shiirchandra/esp_racer_car/mechanical/main-enclosure.step

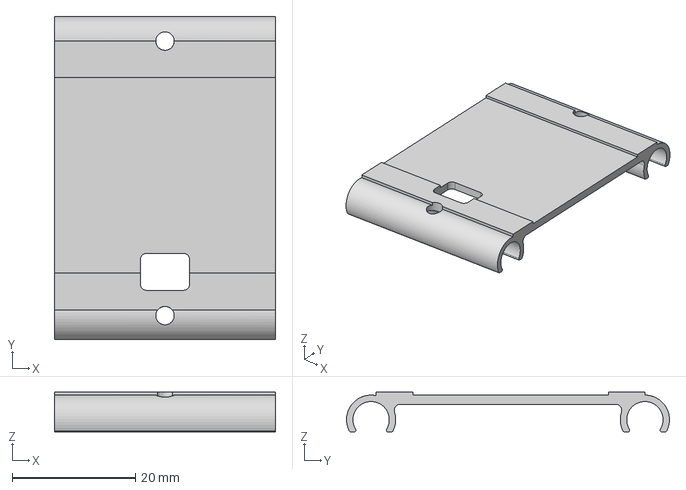
[picture p1: CAD file, 2025-01-25]
mechanical/main-enclosure.step
36.0 x 52.5 x 6.50 mm
