shiirchandra/esp_racer_car/mechanical/wheel.step

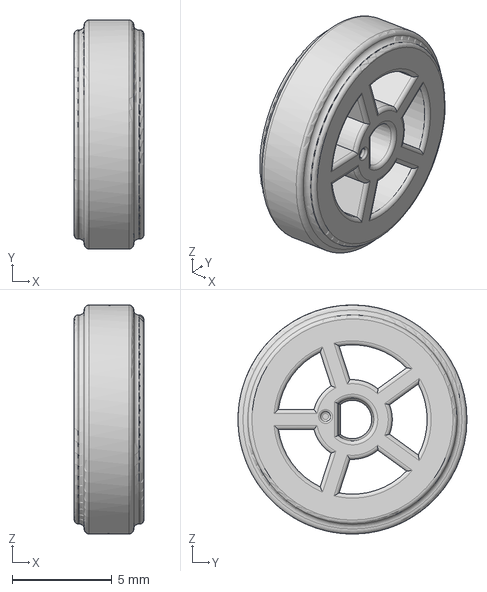
[picture p2: CAD file, 2025-01-25]
mechanical/wheel.step
3.50 x 11.5 x 11.5 mm
