shiirchandra/esp_racer_car/mechanical/top-enclosure.step

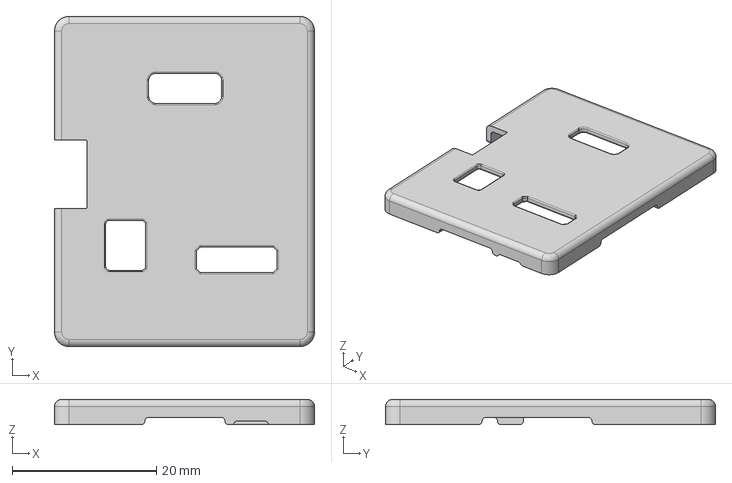
[picture p3: CAD file, 2025-01-25]
mechanical/top-enclosure.step
36.0 x 45.7 x 3.50 mm
