shiirchandra/esp_racer_car/hardware/thumbtroller/controller.kicad_pcb

## KiCad design hardware/thumbtroller/controller.kicad_pcb (2025-01-25)

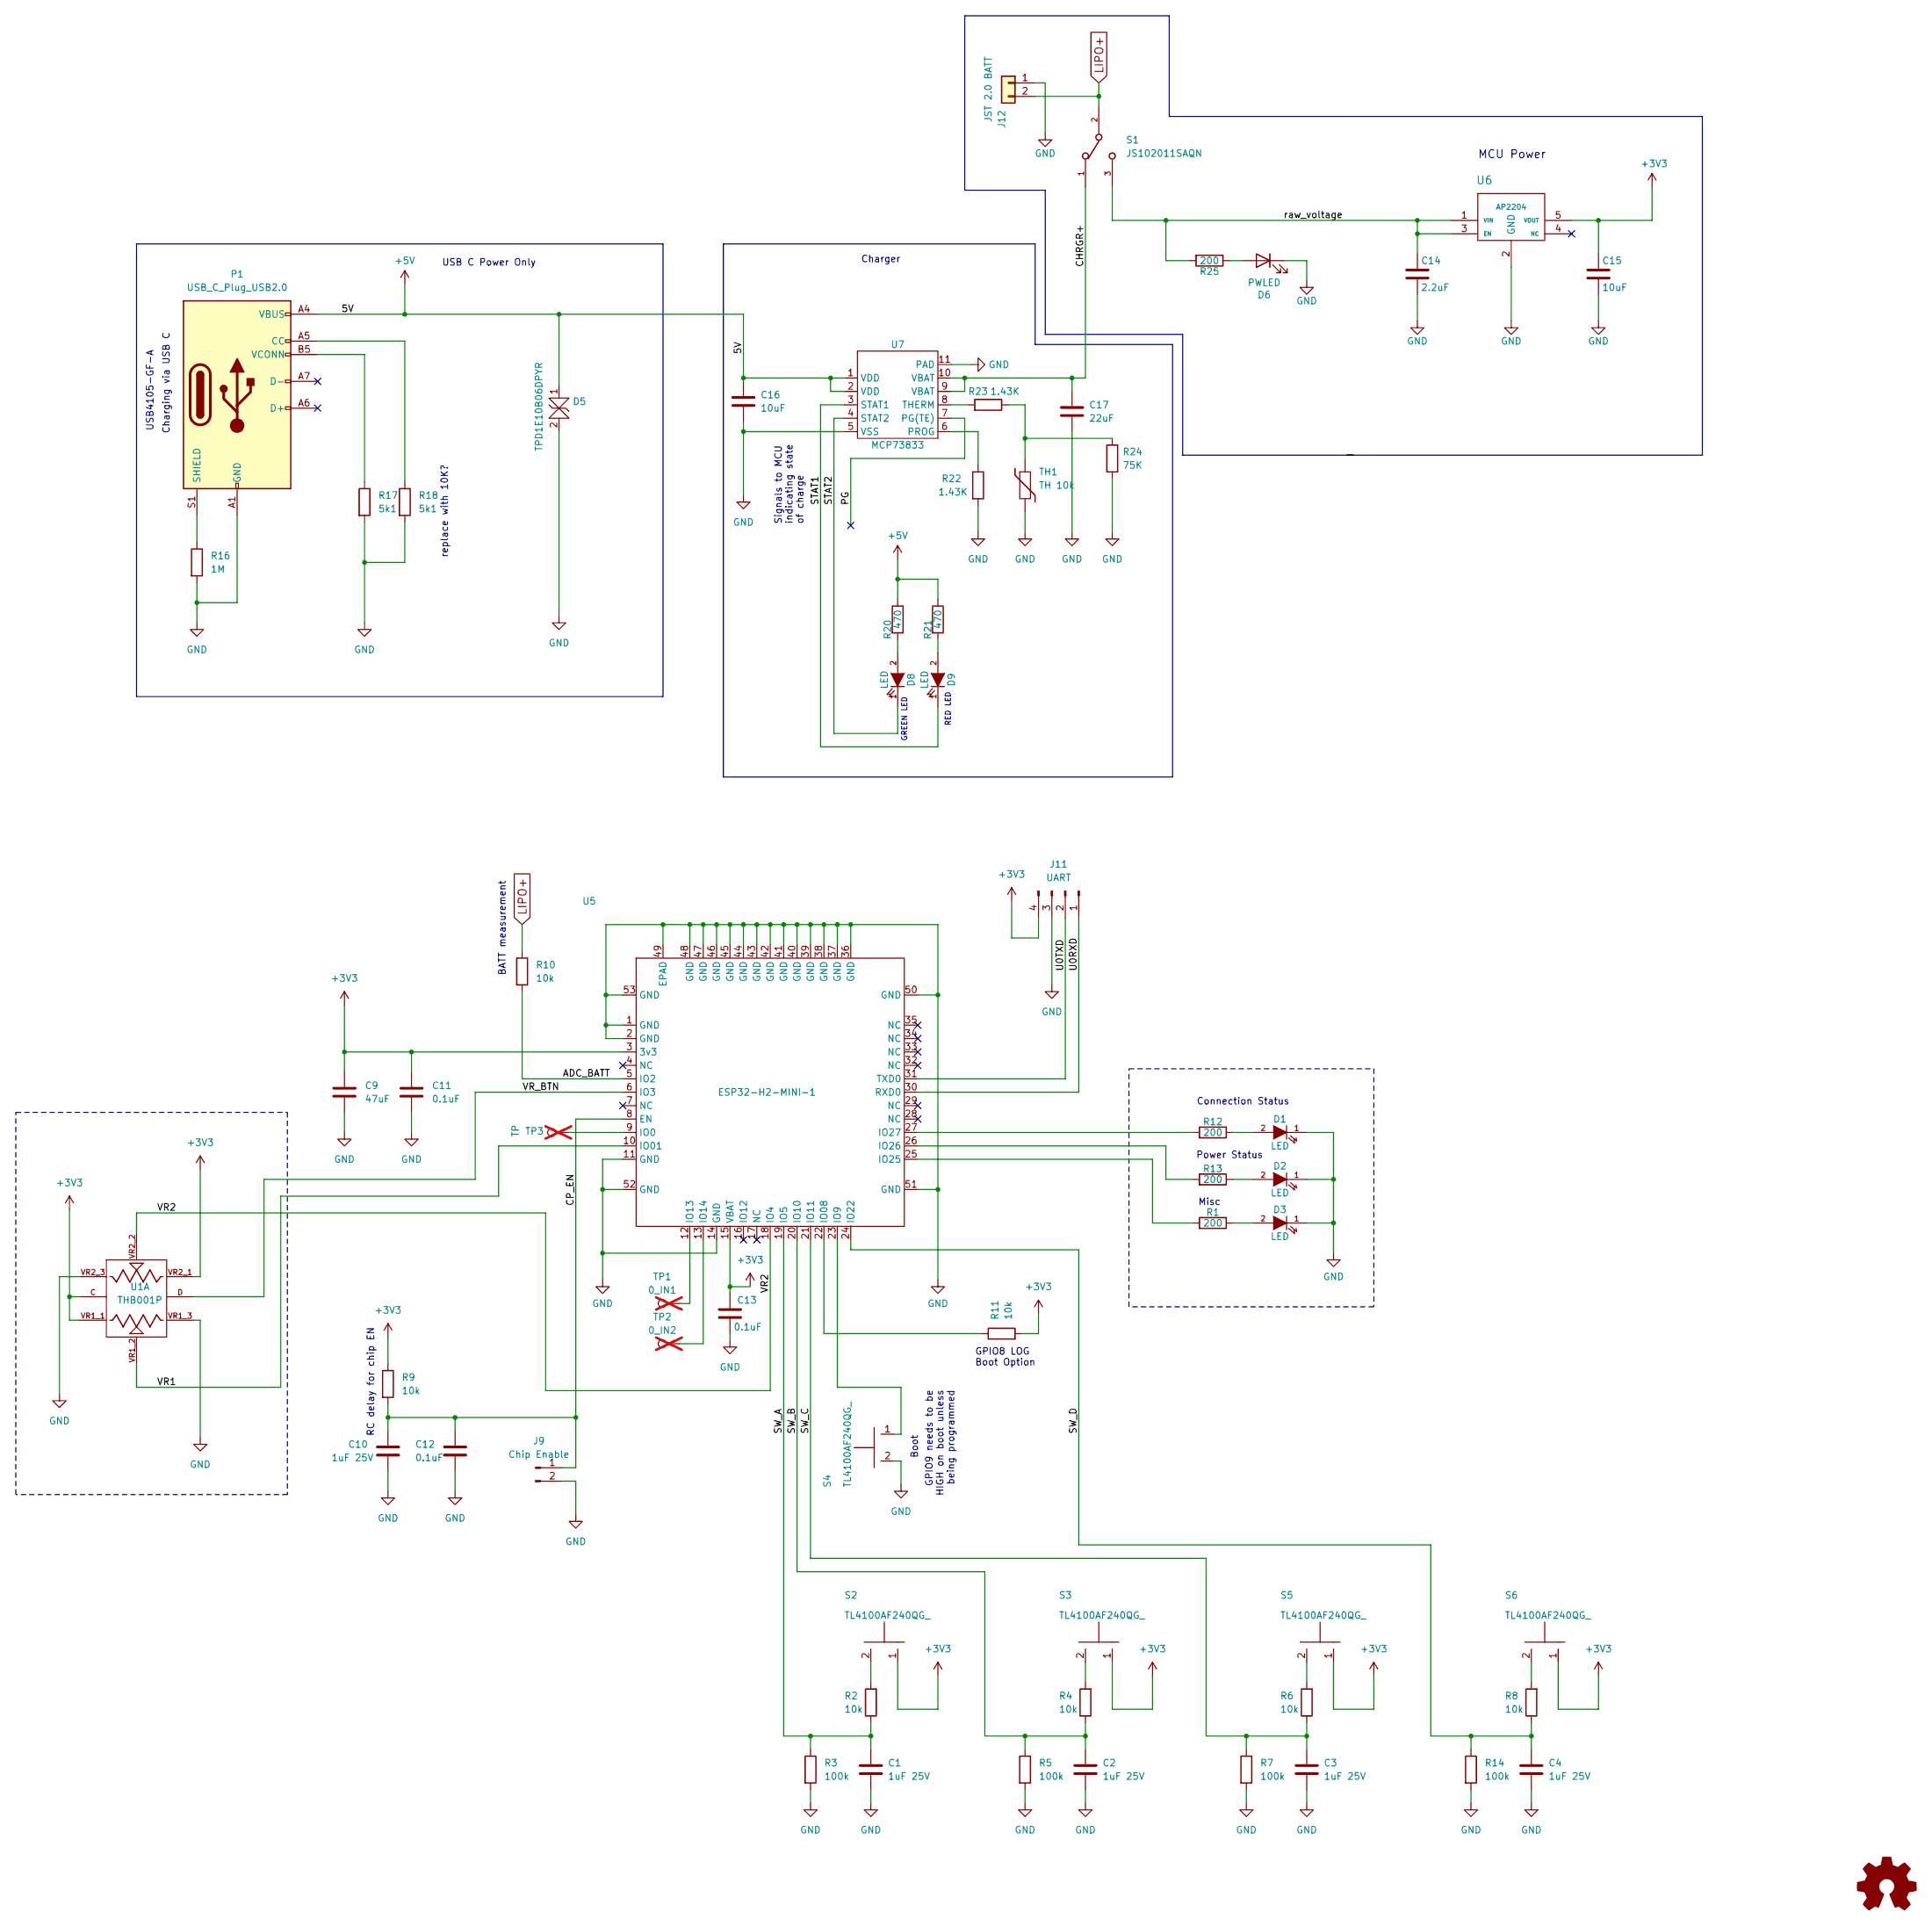
[picture p4: schematic controller.kicad_sch, Thumbtroller]

Parts:
C1, C2, C3, C4, C10: 1uF 25V; C_0603_1608Metric
C9: 47uF; C_0603_1608Metric
C11, C12, C13: 0.1uF; C_0603_1608Metric
C14: 2.2uF; C_0603_1608Metric
C15, C16: 10uF; C_0603_1608Metric
C17: 22uF; C_0603_1608Metric
D1, D2, D3, D8, D9: LED; C_0603_1608Metric
D5: TPD1E10B06DPYR; D_SOD-523
D6: PWLED; D_0603_1608Metric
J9: Chip Enable; PinHeader_1x02_P2.54mm_Vertical
J11: UART; PinHeader_1x04_P2.54mm_Vertical
J12: JST 2.0 BATT; JST_PH_B2B-PH-K_1x02_P2.00mm_Vertical
P1: USB_C_Plug_USB2.0; GCT_USB4105-GF-A
R1, R12, R13, R25: 200; R_0603_1608Metric
R2, R4, R6, R8, R9, R10, R11: 10k; R_0603_1608Metric
R3, R5, R7, R14: 100k; R_0603_1608Metric
R16: 1M; R_0603_1608Metric
R17, R18: 5k1; R_0603_1608Metric
R20, R21: 470; R_0603_1608Metric
R22, R23: 1.43K; R_0603_1608Metric
R24: 75K; R_0603_1608Metric
S1: JS102011SAQN; SW_JS102011SAQN
S2, S3, S4, S5, S6: TL4100AF240QG_; SW_PTS810_SJM_250_SMTR_LFS
TH1: TH 10k; R_0603_1608Metric
TP1: 0_IN1; TestPoint_Pad_1.0x1.0mm; not fitted
TP2: 0_IN2; TestPoint_Pad_1.0x1.0mm; not fitted
TP3: TP; TestPoint_Pad_D1.0mm; not fitted
U1: THB001P; CNK_THB001P; PARTREV 27 Jan 22
U5: ESP32-H2-MINI-1; MODULE_ESP32-H2-MINI-1-H2
U6: AP2204
U7: MCP73833; SON50P300X300X100-11N

Connections:
+3V3: C9.1, C11.1, C13.1, C15.1, J11.4, R9.1, R11.2, S2.1, S3.1, S5.1, S6.1, U1.C, U1.VR1_1, U1.VR2_1, U5.3 (3v3), U5.15 (VBAT), U6.5 (VOUT)
+5V: C16.1, D5.1, P1.A4 (VBUS), P1.A9 (VBUS), P1.B4 (VBUS), P1.B9 (VBUS), R20.1, R21.1, U7.1 (VDD), U7.2 (VDD)
/ADC_BATT: R10.2, U5.5 (IO2)
/CHRGR+: C17.1, S1.1, U7.9 (VBAT), U7.10 (VBAT)
/CP_EN: C10.1, C12.1, J9.1, R9.2, U5.8 (EN)
/PG: U7.7 (PG(TE))
/STAT1: D9.1 (K), U7.3 (STAT1)
/STAT2: D8.1 (K), U7.4 (STAT2)
/SW_A: C1.1, R2.1, R3.1, U5.19 (IO5)
/SW_B: C2.1, R4.1, R5.1, U5.20 (IO10)
/SW_C: C3.1, R6.1, R7.1, U5.21 (IO11)
/SW_D: C4.1, R8.1, R14.1, U5.24 (IO22)
/U0RXD: J11.1, U5.30 (RXD0)
/U0TXD: J11.2, U5.31 (TXD0)
/VR1: U1.VR1_2, U5.10 (IO01)
/VR2: U1.VR2_2, U5.18 (IO4)
/VR_BTN: U1.D, U5.6 (IO3)
/raw_voltage: C14.1, R25.2, S1.3, U6.1 (VIN), U6.3 (EN)
GND: C1.2, C2.2, C3.2, C4.2, C9.2, C10.2, C11.2, C12.2, C13.2, C14.2, C15.2, C16.2, C17.2, D1.1 (K), D2.1 (K), D3.1 (K), D5.2, D6.1 (K), J9.2, J11.3, J12.1, P1.A1 (GND), P1.A12 (GND), P1.B1 (GND), P1.B12 (GND), R3.2, R5.2, R7.2, R14.2, R16.2, R17.2, R18.2, R22.2, R24.1, S4.2, TH1.2, U1.VR1_3, U1.VR2_3, U5.1 (GND), U5.2 (GND), U5.11 (GND), U5.14 (GND), U5.36 (GND), U5.37 (GND), U5.38 (GND), U5.39 (GND), U5.40 (GND), U5.41 (GND), U5.42 (GND), U5.43 (GND), U5.44 (GND), U5.45 (GND), U5.46 (GND), U5.47 (GND), U5.48 (GND), U5.49 (EPAD), U5.50 (GND), U5.51 (GND), U5.52 (GND), U5.53 (GND), U6.2 (GND), U7.5 (VSS), U7.11 (PAD)
LIPO+: J12.2, R10.1, S1.2
unnamed: D1.2 (A), R12.1
unnamed: D2.2 (A), R13.1
unnamed: D3.2 (A), R1.1
unnamed: D6.2 (A), R25.1
unnamed: D8.2 (A), R20.2
unnamed: D9.2 (A), R21.2
unnamed: P1.A5 (CC), R18.1
unnamed: P1.S1 (SHIELD), R16.1
unnamed: P1.B5 (VCONN), R17.1
unnamed: R2.2, S2.2
unnamed: R4.2, S3.2
unnamed: R6.2, S5.2
unnamed: R8.2, S6.2
unnamed: R23.1, R24.2, TH1.1
unnamed: TP3.1, U5.9 (IO0)
unnamed: R11.1, U5.22 (IO08)
unnamed: S4.1, U5.23 (IO9)
unnamed: TP1.1, U5.12 (IO13)
unnamed: TP2.1, U5.13 (IO14)
unnamed: R1.2, U5.25 (IO25)
unnamed: R13.2, U5.26 (IO26)
unnamed: R12.2, U5.27 (IO27)
unnamed: R22.1, U7.6 (PROG)
unnamed: R23.2, U7.8 (THERM)

Notes on the sheet:
RED LED
BATT measurement
Charging via USB C
Signals to MCU indicating state of charge
RC delay for chip EN
replace with 10K?
Connection Status
GPIO8 LOG Boot Option
Boot
GPIO9 needs to be HIGH on boot unless being programmed
Charger
USB4105-GF-A
Power Status
MCU Power
GREEN LED
USB C Power Only
Misc

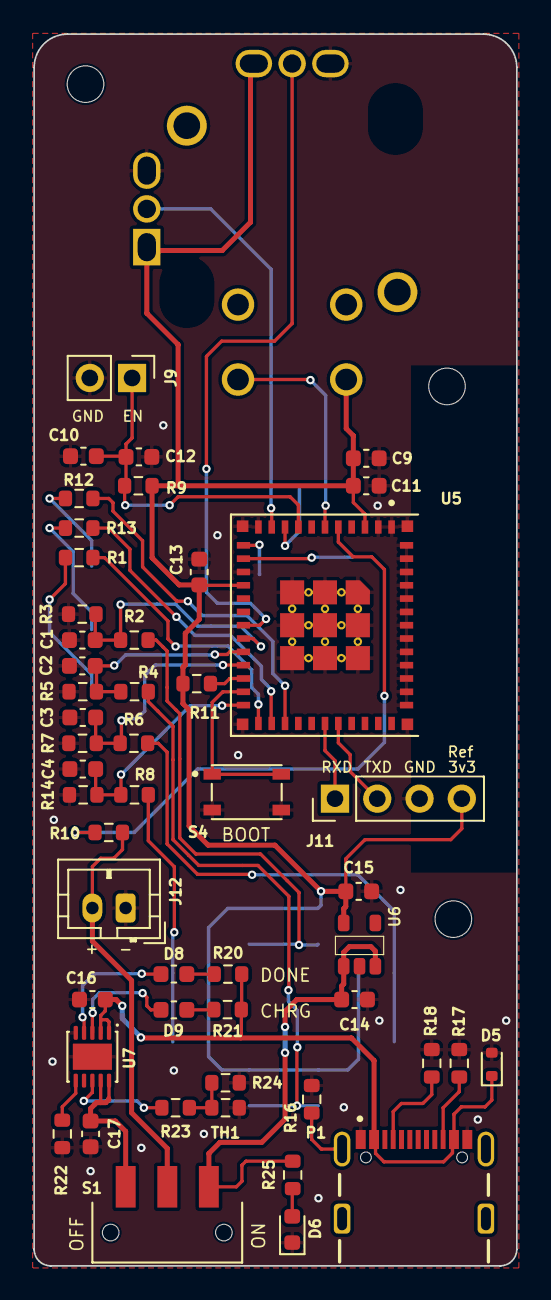
[picture p5: board controller.kicad_pcb from above]

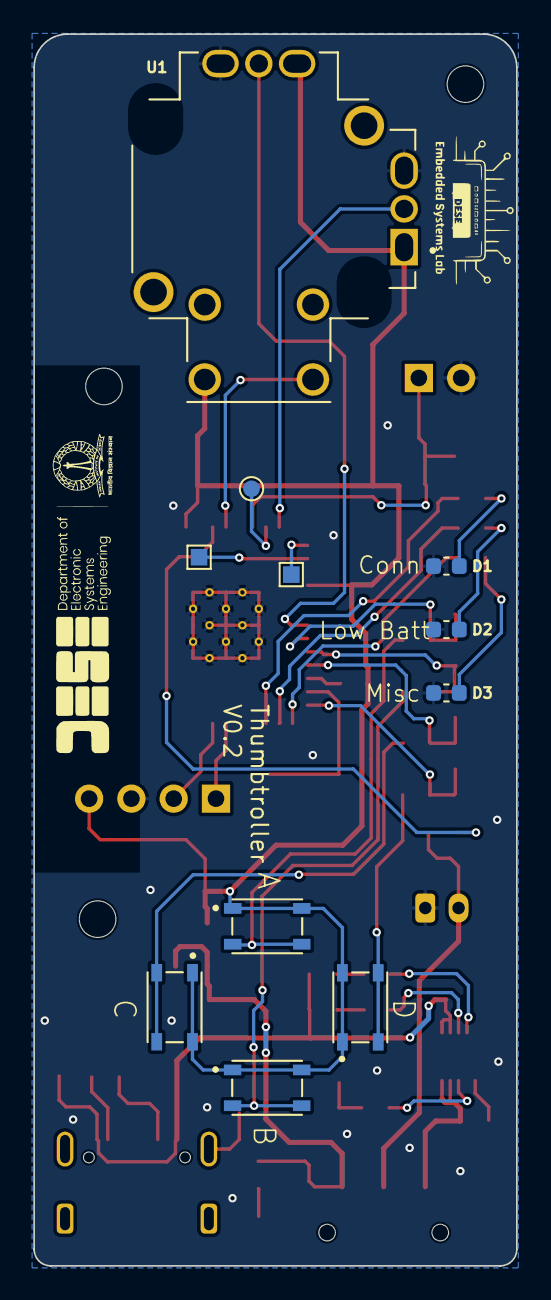
[picture p6: board controller.kicad_pcb from below]

Board: 4 copper layers, 29.0 x 74.0 mm, 61 parts (11 on the bottom side), 43 nets.
