shiirchandra/esp_racer_car/hardware/racer-sensors/sensors.kicad_pcb

## KiCad design hardware/racer-sensors/sensors.kicad_pcb (2025-01-25)

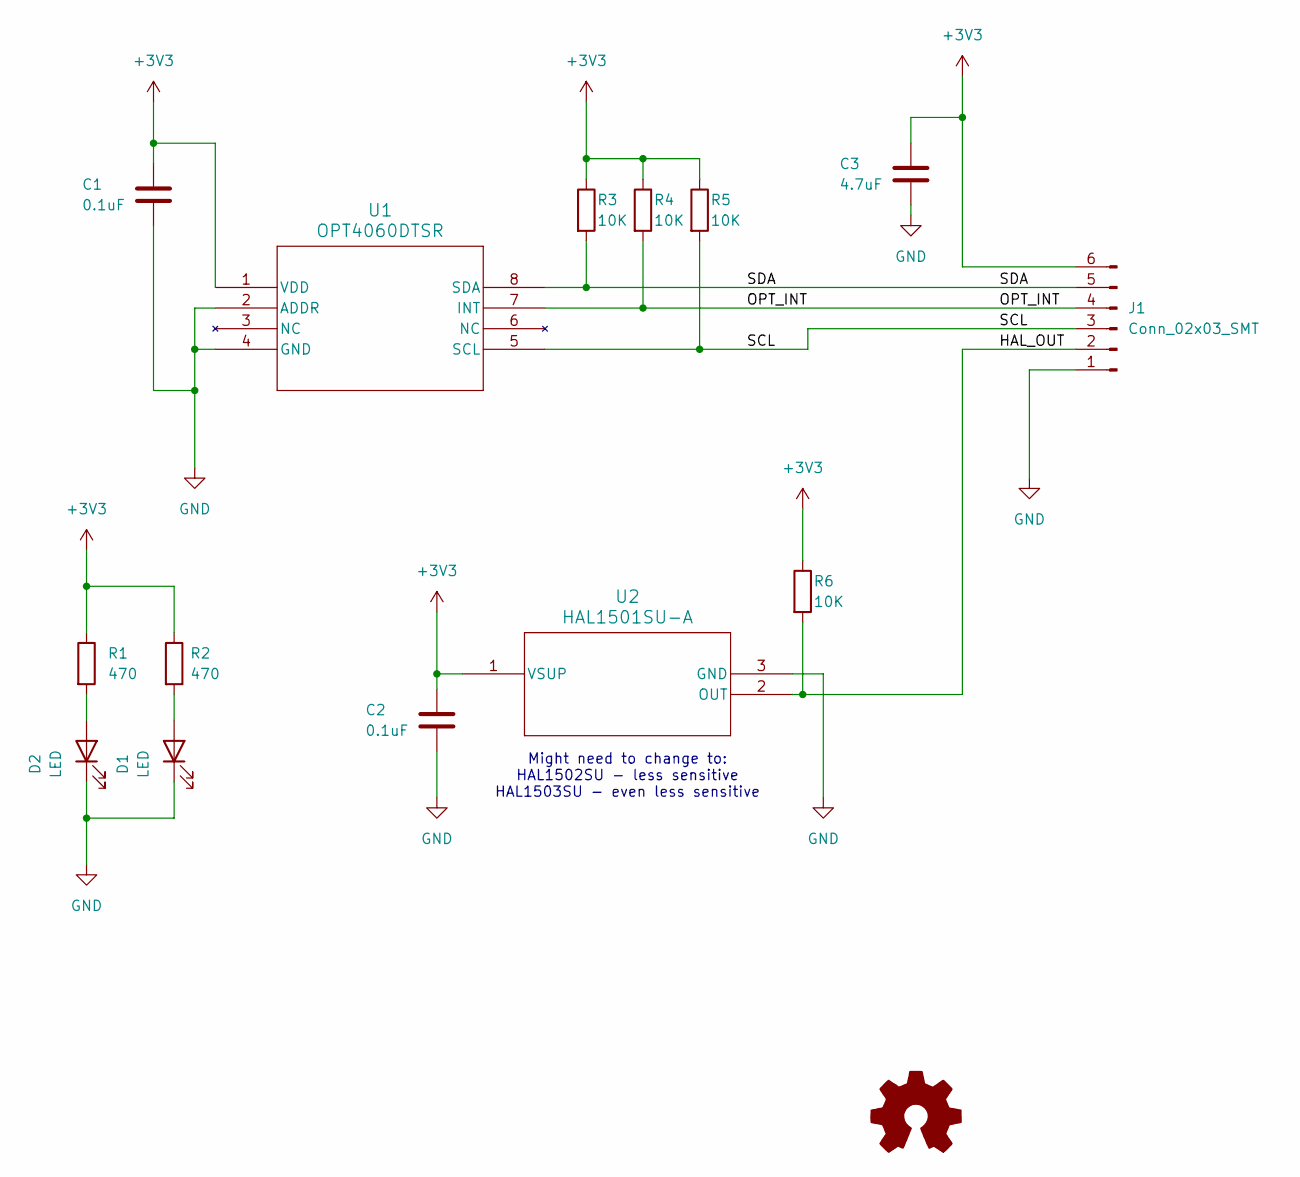
[picture p7: schematic sensors.kicad_sch, Racer-Sensors]

Parts:
C1, C2: 0.1uF; C_0603_1608Metric
C3: 4.7uF; C_0603_1608Metric
D1, D2: LED; LED_0603_1608Metric
J1: Conn_02x03_SMT; PinHeader_2x03_P1.27mm_Vertical_SMD
R1, R2: 470; R_0603_1608Metric
R3, R4, R5, R6: 10K; R_0603_1608Metric
U1: OPT4060DTSR; FCSOT8_DTS_TEX
U2: HAL1501SU-A; SOT-23_TO-236_TDK

Connections:
+3V3: C1.1, C2.1, C3.1, J1.6, R1.1, R2.1, R3.1, R4.1, R5.1, R6.1, U1.1 (VDD), U2.1 (VSUP)
/HAL_OUT: J1.2, R6.2, U2.2 (OUT)
/OPT_INT: J1.4, R4.2, U1.7 (INT)
/SCL: J1.3, R5.2, U1.5 (SCL)
/SDA: J1.5, R3.2, U1.8 (SDA)
GND: C1.2, C2.2, C3.2, D1.1 (K), D2.1 (K), J1.1, U1.2 (ADDR), U1.4 (GND), U2.3 (GND)
unnamed: D1.2 (A), R2.2
unnamed: D2.2 (A), R1.2

Notes on the sheet:
Might need to change to: HAL1502SU - less sensitive HAL1503SU - even less sensitive

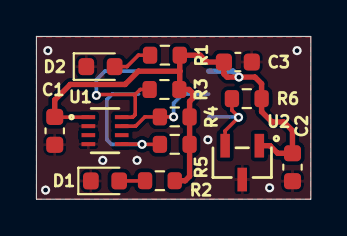
[picture p8: board sensors.kicad_pcb from above]

Board: 4 copper layers, 15.2 x 9.0 mm, 14 parts (1 on the bottom side), 8 nets.
